1537896552/acoustic-messenger/team67-media/通67组电设-封面.jpg

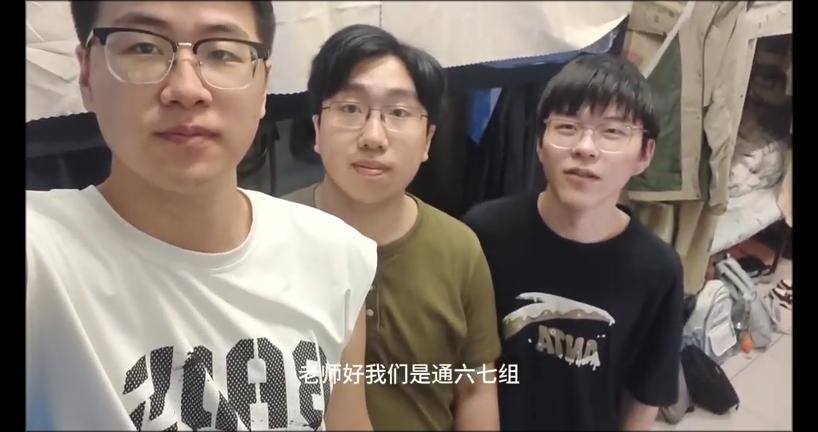
team67-media/通67组电设-封面.jpg
