1537896552/acoustic-messenger/materials/声语信使基础题电路设计方案.docx

声语信使基础题电路设计方案

1. 设计目标

本方案面向基础题，优先保证能稳定完成数字短信息通信、0.5 m 通信距离、发信/收信指示灯和一键开关机。

推荐做成一块“通用终端板”：每块板同时带键盘、OLED、扬声器发送电路、驻极体话筒接收电路。基础题测试时，两块板分别配置为发信端和收信端；后续如果要做提高题的半双工，也不用重新画硬件。

推荐调制方式：4FSK，四个频点为 1500 Hz、1600 Hz、1700 Hz、1800 Hz，每个码元 100 ms。发信端用定时器 PWM 输出音频方波，收信端用 ADC 采样后做 Goertzel 频率检测。

2. 总体结构

5V 输入
|
+-- 一键软开关电路 -- 5V_SW -- 3.3V 稳压 -- STM32F103C8T6
| |
| +-- OLED I2C 显示
| +-- 4x4 矩阵键盘
| +-- 发信/收信指示灯
| +-- PWM 音频输出 -> 扬声器驱动
| +-- ADC 音频输入 <- 话筒放大电路
|
+-- 话筒偏置、运放供电
5V_SW ----------------------------+-- 扬声器功率驱动

两个终端必须使用完全独立的 5V 电源，测试时不要让两台终端共用 USB 电脑地线。

3. 推荐引脚分配

功能 | STM32 引脚 | 说明
OLED SCL | PB6 | I2C1 SCL，外接 4.7 kΩ 上拉到 3.3V
OLED SDA | PB7 | I2C1 SDA，外接 4.7 kΩ 上拉到 3.3V
键盘 R1-R4 | PA0-PA3 | 矩阵键盘行线
键盘 C1-C4 | PA4-PA7 | 矩阵键盘列线
扬声器 PWM | PA8 | TIM1_CH1，输出 1500-1800 Hz 方波
话筒 ADC | PB0 | ADC_IN8，采样音频信号
发信指示灯 | PB12 | 发声发送时点亮
收信指示灯 | PB13 | 检测到有效声波时点亮
电源保持 PWR_HOLD | PB10 | 高电平保持整机上电
电源按键检测 PWR_KEY | PB11 | 按下为低电平，用于开关机检测
SWDIO/SWCLK | PA13/PA14 | 下载调试接口，必须保留

如果已经按现有代码使用了 PA0-PA7 做键盘、PB6/PB7 做 OLED，这个分配可以直接兼容。

4. 电源与一键开关机电路

基础题要求关机后待机电流不大于 1 mA。只用 MCU 休眠通常不稳，尤其很多 STM32 最小系统板带 AMS1117，静态电流可能超过要求。因此推荐用 P 沟道 MOSFET 做高边软开关，关机时直接切断整机 5V_SW。

4.1 连接方式

器件 | 推荐型号/数值 | 连接
Q1 | AO3401A / IRLML6402，P-MOS | Source 接 5V_IN，Drain 输出 5V_SW
R1 | 1 MΩ | Q1 Gate 拉到 Q1 Source，默认关机
Q2 | 2N7002 / AO3400，N-MOS | Drain 接 Q1 Gate，Source 接 GND
R2 | 100 kΩ | Q2 Gate 下拉到 GND
R3 | 100 Ω | PB10 到 Q2 Gate 串联保护
S1 | 无锁按键 | 一端接 BTN 节点，一端接 GND
R4 | 100 kΩ | BTN 节点上拉到 3.3V_SW
D1 | BAT54 / 1N4148 | 阳极接 Q1 Gate，阴极接 BTN 节点
C1 | 100 µF | 5V_SW 对 GND，整机缓冲
C2 | 100 nF | 靠近 MCU 和运放去耦

4.2 工作逻辑

1. 关机时，Q1 Gate 被 R1 拉到 5V_IN，Q1 关闭，整机 5V_SW 无电，待机电流主要是 MOSFET 漏电，远小于 1 mA。

2. 按下 S1 后，BTN 被拉低，D1 把 Q1 Gate 拉低，Q1 打开，5V_SW 上电。

3. MCU 启动后立刻把 PB10 置高，Q2 导通，继续把 Q1 Gate 拉低，实现松开按键后保持开机。

4. 开机状态下，PB11 检测 BTN。长按 S1 后，程序确认关机，PB10 拉低，松开按键后 Q1 关闭。

注意：如果用 STM32 最小系统板，软开关必须放在最小系统板 5V 输入之前，这样关机时板上的稳压器也会断电。

5. MCU 最小系统

如果用 STM32F103C8T6 最小系统板，可直接使用板上的 8 MHz/72 MHz 时钟、复位和 SWD 接口。如果自行画芯片最小系统，建议：

模块 | 推荐连接
供电 | VDD 接 3.3V，每个 VDD 旁边放 100 nF 去耦
模拟供电 | VDDA 接 3.3V，串 10 Ω 或磁珠更好，旁路 100 nF + 1 µF
BOOT0 | 10 kΩ 下拉到 GND
NRST | 10 kΩ 上拉到 3.3V，按键到 GND，旁路 100 nF
SWD | PA13、PA14、3.3V、GND 引出 4Pin/5Pin 下载口

6. OLED 与键盘

OLED 建议使用 0.96 英寸 I2C OLED，VCC 接 3.3V，GND 接系统地，SCL/SDA 分别接 PB6/PB7。SCL 和 SDA 各加 4.7 kΩ 上拉到 3.3V。

4x4 矩阵键盘接 PA0-PA7。行线 PA0-PA3，列线 PA4-PA7。程序扫描时行线轮流输出低电平，列线输入上拉。为防止误触和干扰，可以在每根键盘线串 100 Ω，软件做 10-20 ms 消抖。

7. 扬声器发送电路

STM32 引脚不能直接驱动低阻扬声器，必须加功率开关。基础题推荐 MOSFET 低边驱动，简单可靠，电流也容易限制。

7.1 连接方式

器件 | 推荐型号/数值 | 连接
Q3 | AO3400 / IRLML2502，N-MOS | Source 接 GND，Drain 接扬声器回路
R21 | 100 Ω | PA8 到 Q3 Gate 串联
R22 | 100 kΩ | Q3 Gate 下拉到 GND
SPK1 | 统一提供扬声器 | 一端接 5V_SW
R23 | 33 Ω，0.5 W | SPK1 另一端串 R23 后接 Q3 Drain
C21 | 470 µF | 5V_SW 对 GND，靠近扬声器驱动
C22 | 100 nF | 5V_SW 对 GND，高频去耦

PA8 输出 50% 占空比方波，频率选择 1500/1600/1700/1800 Hz。R23 用来限流，假设扬声器约 8 Ω，则峰值电流约为 5V / (33Ω + 8Ω) = 122 mA，加上 MCU 和 OLED 后仍明显低于 600 mA。

如果实测声音偏小，可把 R23 降到 22 Ω，但要重新测发信端峰值电流，必须小于 600 mA。

8. 驻极体话筒接收电路

驻极体话筒输出很小，不能直接进 ADC。推荐用 3.3V 单电源轨到轨运放做一级非反相放大，并把信号偏置到 1.65V。

8.1 连接方式

器件 | 推荐型号/数值 | 连接
MIC1 | 驻极体话筒 | 负端接 GND，正端为 MIC+
R31 | 2.2 kΩ | MIC+ 上拉到 3.3V，给话筒偏置
C31 | 1 µF | MIC+ 串联耦合到运放正输入
R32/R33 | 100 kΩ / 100 kΩ | 3.3V 分压产生 VREF=1.65V
C32 | 10 µF | VREF 对 GND 滤波
C33 | 100 nF | VREF 对 GND 高频去耦
R34 | 100 kΩ | 运放正输入拉到 VREF
U1A | MCP6002 / LMV358 | 3.3V 单电源运放
R35 | 2.2 kΩ | 运放负输入到 VREF
R36 | 68 kΩ | 运放输出反馈到负输入
R37 | 1 kΩ | 运放输出串到 PB0 ADC
C34 | 4.7 nF | PB0 ADC 对 GND，简单低通抗毛刺

放大倍数约为 1 + 68k / 2.2k = 31.9 倍。若现场声音较小，可以把 R36 改为 100 kΩ；若 ADC 波形削顶，可以把 R36 改为 47 kΩ。

ADC 采样率建议 8 kHz 或 10 kHz。4FSK 每个码元 100 ms，8 kHz 采样时每个码元有 800 点，足够做 Goertzel 检测。

9. 指示灯电路

发信指示灯和收信指示灯各用一个 GPIO 控制即可。

指示灯 | 连接
LED_TX | PB12 -> 1 kΩ -> LED -> GND，发声时 PB12 输出高电平
LED_RX | PB13 -> 1 kΩ -> LED -> GND，检测到有效声波时 PB13 输出高电平

如果想降低功耗，LED 电阻可改为 2.2 kΩ 或 3.3 kΩ。

10. 基础题两台终端如何装配

为了省时间，建议两台终端都焊同一块通用板。

终端 | 必须使用的模块 | 可不焊/可关闭的模块
发信终端 | MCU、OLED、键盘、扬声器驱动、LED_TX、电源软开关 | 话筒放大、LED_RX 可先不焊
收信终端 | MCU、OLED、话筒放大、LED_RX、电源软开关 | 键盘、扬声器驱动、LED_TX 可先不焊
通用终端 | 全部焊接 | 基础题时软件选择 TX 或 RX 模式

如果后面要冲半双工，提高题建议两台都焊全。

11. 元件清单

类别 | 元件 | 数量/每台 | 备注
控制 | STM32F103C8T6 最小系统或自画最小系统 | 1 | 保留 SWD
显示 | I2C OLED | 1 | 3.3V 供电
输入 | 4x4 矩阵键盘 | 1 | 无锁按键
声发射 | 扬声器 | 1 | 统一提供型号
声接收 | 驻极体话筒 | 1 | 统一提供型号
运放 | MCP6002 / LMV358 | 1 | 3.3V 单电源
功率管 | AO3400 N-MOS | 1 | 扬声器驱动
软开关 | AO3401A P-MOS + 2N7002 N-MOS | 各 1 | 一键开关机
指示灯 | LED + 1 kΩ 电阻 | 2 | 发信、收信
阻容 | 100 nF、1 µF、10 µF、100 µF、470 µF 等 | 若干 | 每个芯片旁边必须有去耦

12. 调试顺序

1. 先只焊电源软开关和 3.3V 稳压，确认短按能上电，长按能关机，关机电流小于 1 mA。

2. 焊 MCU、OLED、键盘，确认能输入并显示 0-9 数字短信息。

3. 焊扬声器驱动，单独播放 1500/1600/1700/1800 Hz，手机频谱软件能看到对应频率。

4. 焊话筒放大电路，用示波器或 ADC 打印确认安静时 PB0 在 1.65V 附近，有声音时围绕 1.65V 摆动且不削顶。

5. 做单码元识别，只发送一个频点，接收端能识别四个频点。

6. 加前导码、长度、数据、校验，完成 1-48 位数字短信息通信。

7. 最后测试 0.5 m 距离和自然环境噪声下的稳定性。

13. 关键注意事项

• 两台终端不能共地。调试通信距离时，最好用两个充电宝分别供电。

• 扬声器电流必须测峰值，不能超过 600 mA。R23 是限流关键器件，不要直接短接。

• 话筒放大输出必须在 0-3.3V 之间，不能低于 0V 或高于 3.3V，否则可能损坏 ADC。

• OLED 和键盘线尽量远离扬声器大电流回路，话筒输入线也要远离 PA8 和扬声器线。

• 话筒前端的 VREF 要滤波干净，C32、C33 要靠近运放。

• 如果接收误码多，优先检查话筒放大是否削顶、扬声器是否太小声、频点间隔是否准确、Goertzel 窗口是否对齐。
