1537896552/acoustic-messenger/(list of files, drawings)

Other design files:
MCP6004滤波器.ms14
