1537896552/acoustic-messenger/(commit log)

2026-07-03 初始提交：声语信使基础题电路设计方案
2026-07-03 添加README文档
2026-07-03 添加工作日志、仿真记录及代码工程文件
2026-07-03 更新README目录结构
2026-07-03 MAP6004仿真工程
    [MAP6004.ms14]
2026-07-03 Add reference for custom signal generation with PWM
2026-07-04 Update 参考资料
2026-07-04 前级放大器和滤波器的仿真
    [MCP6004滤波器.ms14]
2026-07-06 添加4FSK固件HEX文件及新增材料
2026-07-06 文件夹英文化：材料→materials，通67组电设→team67-media
2026-07-06 更新README：修正参数，英文目录结构
2026-07-22 Add STM32F103C8 datasheet link to references
